alx-alexpark/macropad/macropad.kicad_pcb

## KiCad design macropad.kicad_pcb (2025-03-19)

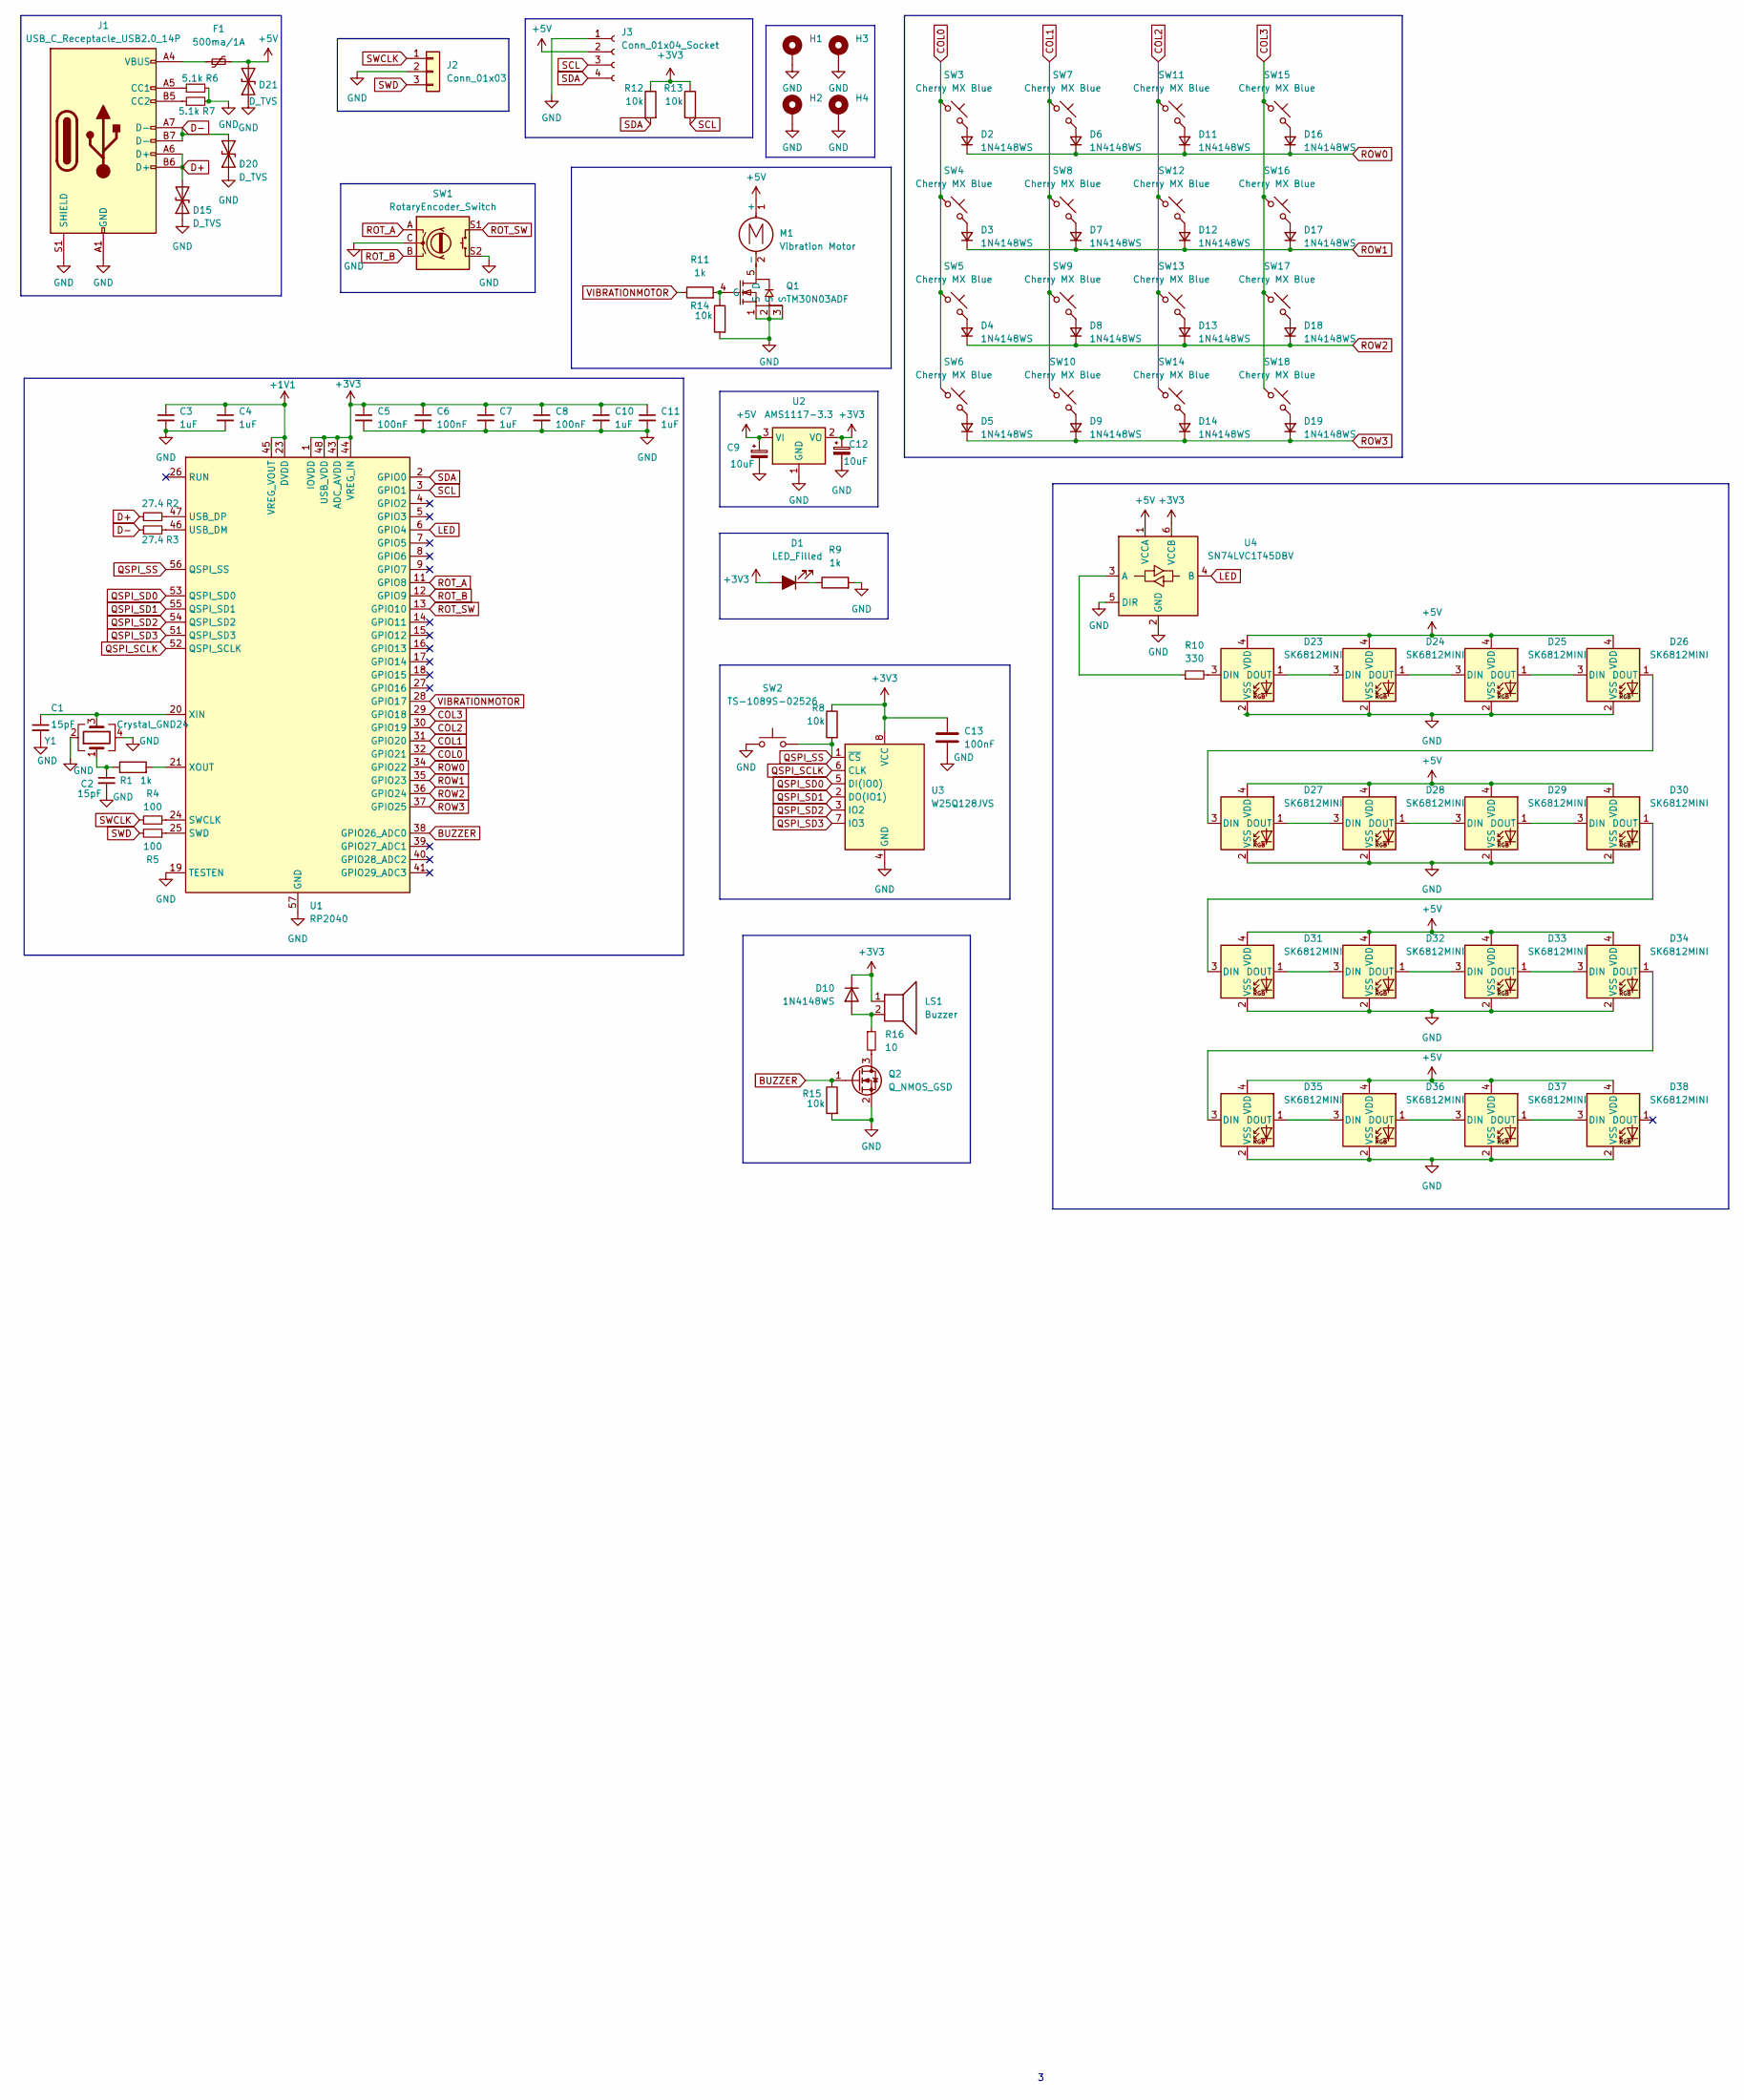
[picture p1: schematic macropad.kicad_sch]

Parts:
C1, C2: 15pF; C_0402_1005Metric; LCSC Part C1548
C3, C4, C7, C10, C11: 1uF; C_0402_1005Metric; LCSC Part C52923
C5, C6, C8, C13: 100nF; C_0402_1005Metric; LCSC Part C1525
C9, C12: 10uF; C_1206_3216Metric; LCSC Part C7171
D1: LED_Filled; LED_0603_1608Metric; LCSC Part C2286
D2, D3, D4, D5, D6, D7, D8, D9, D11, D12, D13, D14, D16, D17, D18, D19: 1N4148WS; D_SOD-323F; LCSC Part C917117
D10: 1N4148WS; D_SOD-323; LCSC Part C2828422
D15, D20, D21: D_TVS; D_SOD-923; LCSC Part C96512
D23, D24, D25, D26, D27, D28, D29, D30, D31, D32, D33, D34, D35, D36, D37, D38: SK6812MINI; SK6812MINI-E; LCSC Part C5149201
F1: 500ma/1A; Fuse_1206_3216Metric_Pad1.42x1.75mm_HandSolder; LCSC Part C720075
H1, H2, H3, H4: MountingHole_Pad; MountingHole_2.2mm_M2_DIN965_Pad
J1: USB_C_Receptacle_USB2.0_14P; USB_C_Receptacle_G-Switch_GT-USB-7010ASV; LCSC Part C2988369
J2: Conn_01x03; JST_SH_BM03B-SRSS-TB_1x03-1MP_P1.00mm_Vertical; LCSC Part C160389
J3: Conn_01x04_Socket; OLED-TH_L38.0-W12.0_HS91L02W2C01; LCSC Part C5248081
LS1: Buzzer; BUZ-SMD_4P-L8.5-W8.5-P8.50-BR; LCSC Part C94599
M1: Vibration Motor; PinHeader_1x02_P2.54mm_Vertical
Q1: TM30N03ADF; WDFN-5_L3.3-W3.3-P0.65-BL; LCSC Part C7422839
Q2: Q_NMOS_GSD; SOT-23_Handsoldering; LCSC Part C347475
R1, R9, R11: 1k; R_0402_1005Metric; LCSC Part C11702
R2, R3: 27.4; R_0603_1608Metric; LCSC Part C5126244
R4, R5: 100; R_0603_1608Metric_Pad0.98x0.95mm_HandSolder; LCSC Part C7250
R6, R7: 5.1k; R_0603_1608Metric_Pad0.98x0.95mm_HandSolder; LCSC Part C23186
R8, R12, R13, R14, R15: 10k; R_0805_2012Metric; LCSC Part C17414
R10: 330; R_0603_1608Metric_Pad0.98x0.95mm_HandSolder; LCSC Part C23138
R16: 10; R_0603_1608Metric_Pad0.98x0.95mm_HandSolder; LCSC Part C22859
SW1: RotaryEncoder_Switch; SW-TH_EC11XXXXXXXX; LCSC Part C470742
SW2: TS-1089S-02526; SW-SMD_4P-L4.2-W3.3-P2.15-LS5.1; LCSC Part C455282
SW3, SW4, SW5, SW6, SW7, SW8, SW9, SW10, SW11, SW12, SW13, SW14, SW15, SW16, SW17, SW18: Cherry MX Blue; SW_Cherry_MX_PCB_1.00u
U1: RP2040; QFN-56-1EP_7x7mm_P0.4mm_EP3.2x3.2mm; LCSC Part C2040
U2: AMS1117-3.3; SOT-223-3_TabPin2; LCSC Part C6186
U3: W25Q128JVS; SOIC-8_5.23x5.23mm_P1.27mm; LCSC Part C97521
U4: SN74LVC1T45DBV; SOT-23-6; LCSC Part C7843
Y1: Crystal_GND24; Crystal_SMD_3225-4Pin_3.2x2.5mm; LCSC Part C20625731

Connections:
+1V1: C3.1, C4.1, U1.23 (DVDD), U1.45 (VREG_VOUT), U1.50 (DVDD)
+3V3: C5.1, C6.1, C7.1, C8.1, C10.1, C11.1, C12.1, C13.1, D1.2 (A), D10.1 (K), LS1.1, R8.1, R12.1, R13.1, U1.1 (IOVDD), U1.10 (IOVDD), U1.22 (IOVDD), U1.33 (IOVDD), U1.42 (IOVDD), U1.43 (ADC_AVDD), U1.44 (VREG_IN), U1.48 (USB_VDD), U1.49 (IOVDD), U2.2 (VO), U3.8 (VCC), U4.6 (VCCB)
+5V: C9.1, D21.2 (A2), D23.4 (VDD), D24.4 (VDD), D25.4 (VDD), D26.4 (VDD), D27.4 (VDD), D28.4 (VDD), D29.4 (VDD), D30.4 (VDD), D31.4 (VDD), D32.4 (VDD), D33.4 (VDD), D34.4 (VDD), D35.4 (VDD), D36.4 (VDD), D37.4 (VDD), D38.4 (VDD), F1.2, J3.2, M1.1 (+), U2.3 (VI), U4.1 (VCCA)
BUZZER: Q2.1 (G), R15.1, U1.38 (GPIO26_ADC0)
COL0: SW3.1, SW4.1, SW5.1, SW6.1, U1.32 (GPIO21)
COL1: SW7.1, SW8.1, SW9.1, SW10.1, U1.31 (GPIO20)
COL2: SW11.1, SW12.1, SW13.1, SW14.1, U1.30 (GPIO19)
COL3: SW15.1, SW16.1, SW17.1, SW18.1, U1.29 (GPIO18)
D+: D15.2 (A2), J1.A6 (D+), J1.B6 (D+), R2.1
D-: D20.2 (A2), J1.A7 (D-), J1.B7 (D-), R3.1
GND: C1.2, C2.2, C3.2, C4.2, C5.2, C6.2, C7.2, C8.2, C9.2, C10.2, C11.2, C12.2, C13.2, D15.1 (A1), D20.1 (A1), D21.1 (A1), D23.2 (VSS), D24.2 (VSS), D25.2 (VSS), D26.2 (VSS), D27.2 (VSS), D28.2 (VSS), D29.2 (VSS), D30.2 (VSS), D31.2 (VSS), D32.2 (VSS), D33.2 (VSS), D34.2 (VSS), D35.2 (VSS), D36.2 (VSS), D37.2 (VSS), D38.2 (VSS), H1.1, H2.1, H3.1, H4.1, J1.A1 (GND), J1.A12 (GND), J1.B1 (GND), J1.B12 (GND), J1.S1 (SHIELD), J2.2, J3.1, Q1.1 (S), Q1.2 (S), Q1.3 (S), Q2.2 (S), R6.2, R7.2, R9.2, R14.2, R15.2, SW1.C, SW1.S2, SW2.1, U1.19 (TESTEN), U1.57 (GND), U2.1 (GND), U3.4 (GND), U4.2 (GND), U4.5 (DIR), Y1.2, Y1.4
LED: U1.6 (GPIO4), U4.4 (B)
unnamed: C2.1, R1.1, Y1.1
unnamed: D1.1 (K), R9.1
unnamed: D2.2 (A), SW3.2
unnamed: D3.2 (A), SW4.2
unnamed: D4.2 (A), SW5.2
unnamed: D5.2 (A), SW6.2
unnamed: D6.2 (A), SW7.2
unnamed: D7.2 (A), SW8.2
unnamed: D8.2 (A), SW9.2
unnamed: D9.2 (A), SW10.2
unnamed: D10.2 (A), LS1.2, R16.1
unnamed: D11.2 (A), SW11.2
unnamed: D12.2 (A), SW12.2
unnamed: D13.2 (A), SW13.2
unnamed: D14.2 (A), SW14.2
unnamed: D16.2 (A), SW15.2
unnamed: D17.2 (A), SW16.2
unnamed: D18.2 (A), SW17.2
unnamed: D19.2 (A), SW18.2
unnamed: D23.3 (DIN), R10.2
unnamed: D23.1 (DOUT), D24.3 (DIN)
unnamed: D24.1 (DOUT), D25.3 (DIN)
unnamed: D25.1 (DOUT), D26.3 (DIN)
unnamed: D26.1 (DOUT), D27.3 (DIN)
unnamed: D27.1 (DOUT), D28.3 (DIN)
unnamed: D28.1 (DOUT), D29.3 (DIN)
unnamed: D29.1 (DOUT), D30.3 (DIN)
unnamed: D30.1 (DOUT), D31.3 (DIN)
unnamed: D31.1 (DOUT), D32.3 (DIN)
unnamed: D32.1 (DOUT), D33.3 (DIN)
unnamed: D33.1 (DOUT), D34.3 (DIN)
unnamed: D34.1 (DOUT), D35.3 (DIN)
unnamed: D35.1 (DOUT), D36.3 (DIN)
unnamed: D36.1 (DOUT), D37.3 (DIN)
unnamed: D37.1 (DOUT), D38.3 (DIN)
unnamed: F1.1, J1.A4 (VBUS), J1.A9 (VBUS), J1.B4 (VBUS), J1.B9 (VBUS)
unnamed: J1.A5 (CC1), R6.1
unnamed: J1.B5 (CC2), R7.1
unnamed: M1.2 (-), Q1.5 (D)
unnamed: Q1.4 (G), R11.2, R14.1
unnamed: Q2.3 (D), R16.2
unnamed: R4.2, U1.24 (SWCLK)
unnamed: R5.1, U1.25 (SWD)
unnamed: R3.2, U1.46 (USB_DM)
unnamed: R2.2, U1.47 (USB_DP)
unnamed: C1.1, U1.20 (XIN), Y1.3
unnamed: R1.2, U1.21 (XOUT)
unnamed: R10.1, U4.3 (A)
QSPI_SCLK: U1.52 (QSPI_SCLK), U3.6 (CLK)
QSPI_SD0: U1.53 (QSPI_SD0), U3.5 (DI(IO0))
QSPI_SD1: U1.55 (QSPI_SD1), U3.2 (DO(IO1))
QSPI_SD2: U1.54 (QSPI_SD2), U3.3 (IO2)
QSPI_SD3: U1.51 (QSPI_SD3), U3.7 (IO3)
QSPI_SS: R8.2, SW2.2, U1.56 (QSPI_SS), U3.1 (~CS)
ROT_A: SW1.A, U1.11 (GPIO8)
ROT_B: SW1.B, U1.12 (GPIO9)
ROT_SW: SW1.S1, U1.13 (GPIO10)
ROW0: D2.1 (K), D6.1 (K), D11.1 (K), D16.1 (K), U1.34 (GPIO22)
ROW1: D3.1 (K), D7.1 (K), D12.1 (K), D17.1 (K), U1.35 (GPIO23)
ROW2: D4.1 (K), D8.1 (K), D13.1 (K), D18.1 (K), U1.36 (GPIO24)
ROW3: D5.1 (K), D9.1 (K), D14.1 (K), D19.1 (K), U1.37 (GPIO25)
SCL: J3.3, R13.2, U1.3 (GPIO1)
SDA: J3.4, R12.2, U1.2 (GPIO0)
SWCLK: J2.1, R4.1
SWD: J2.3, R5.2
VIBRATIONMOTOR: R11.1, U1.28 (GPIO17)

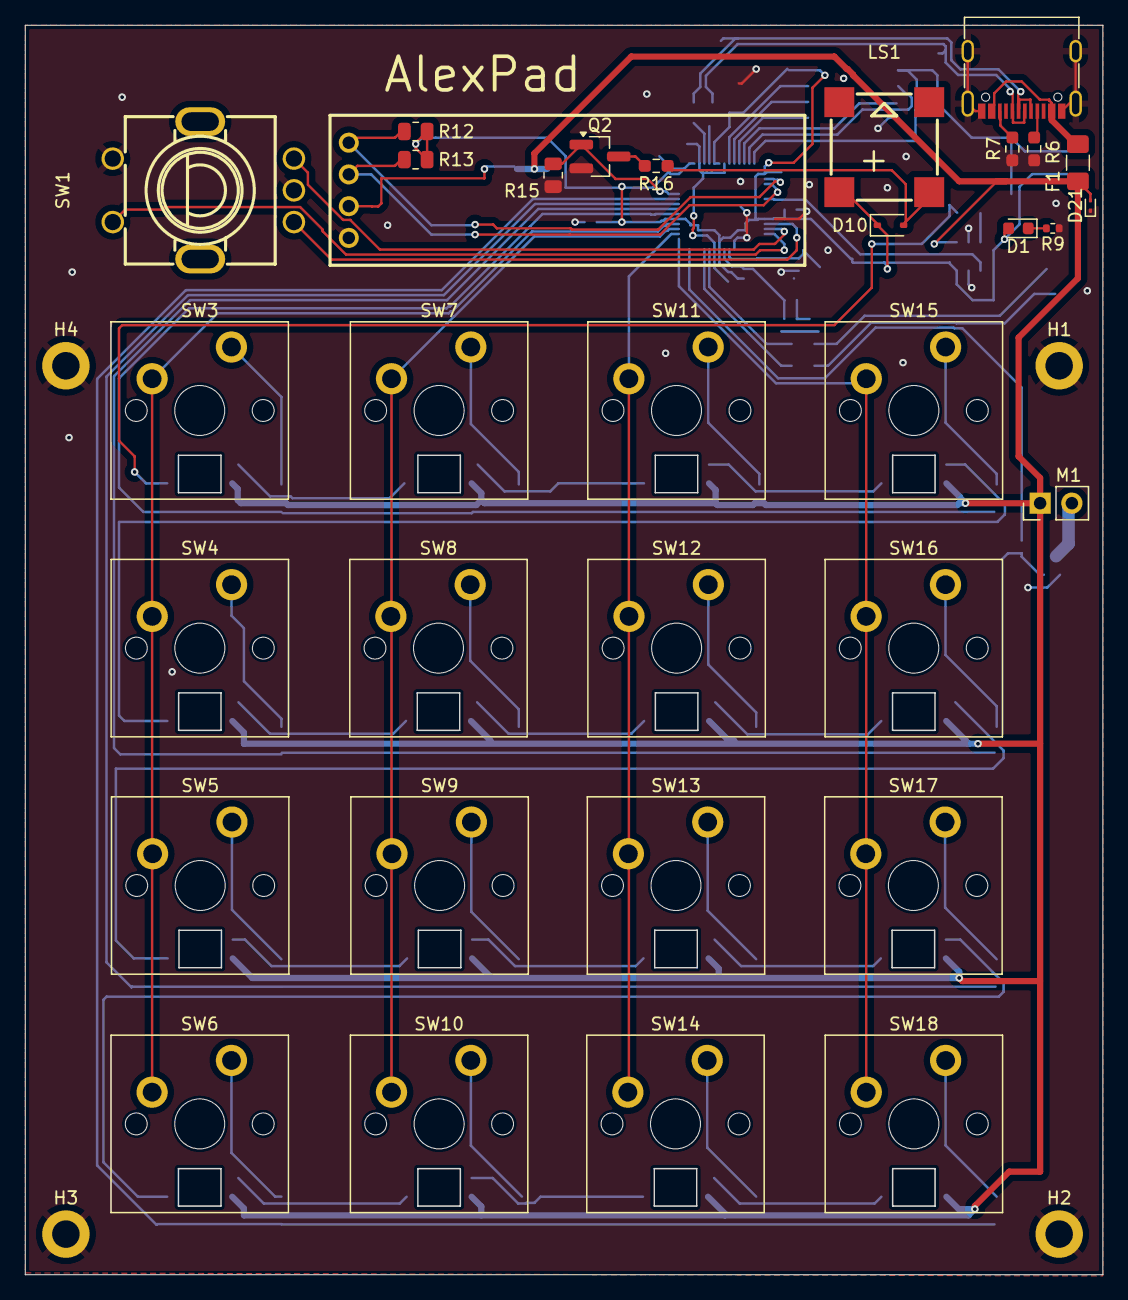
[picture p2: board macropad.kicad_pcb from above]

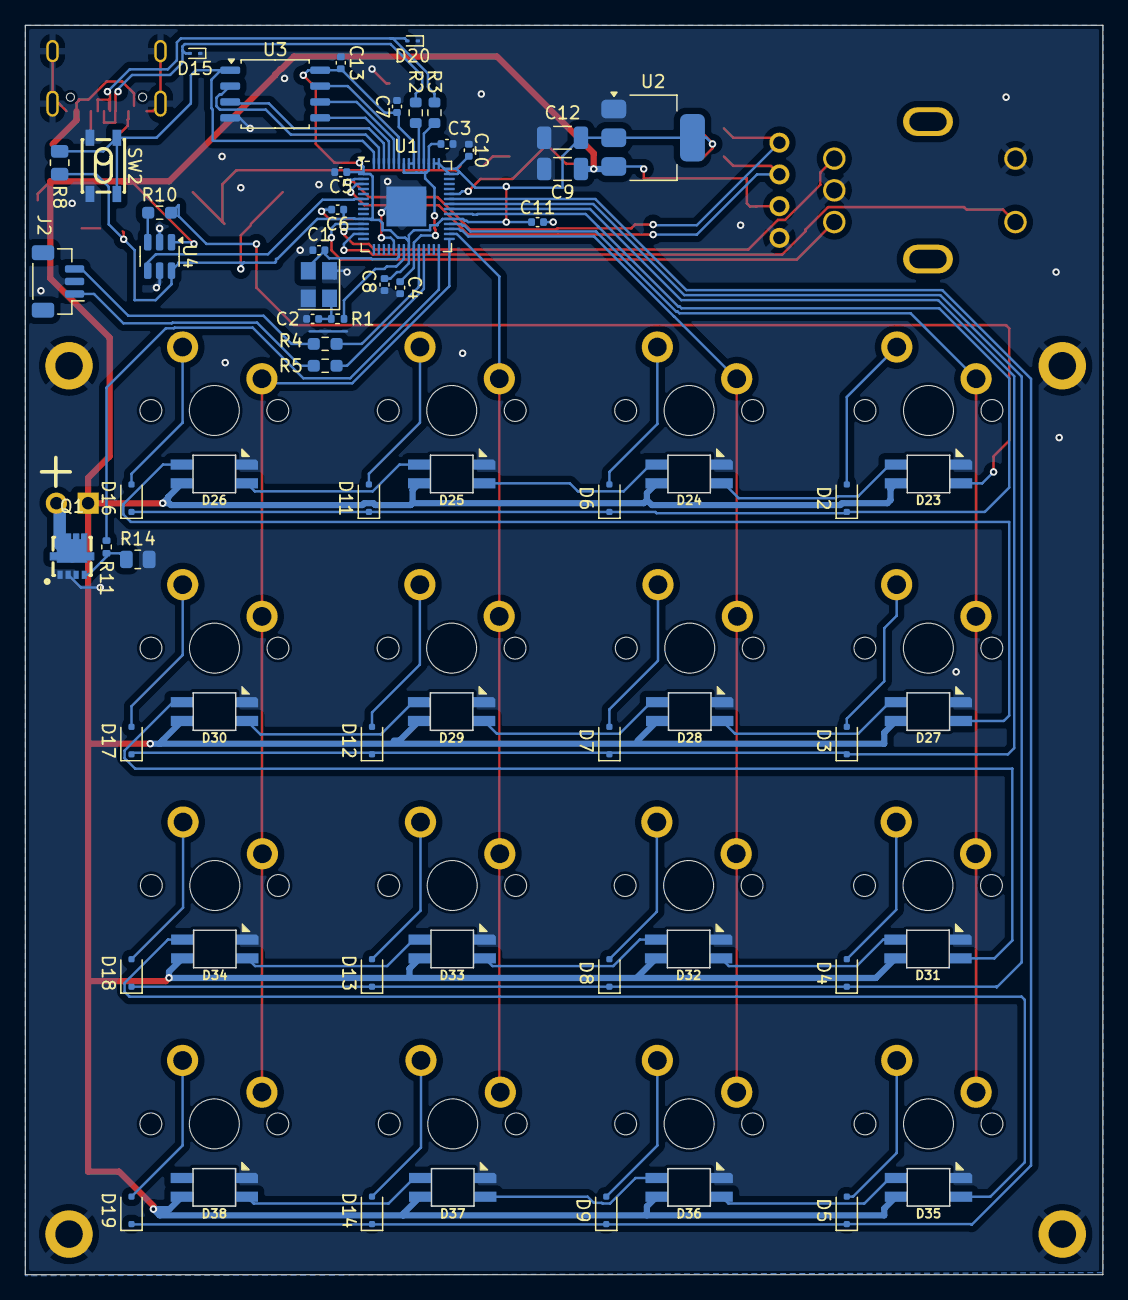
[picture p3: board macropad.kicad_pcb from below]

Board: 2 copper layers, 86.2 x 100.0 mm, 101 parts (64 on the bottom side), 78 nets.
