alx-alexpark/macropad/(commit log)

2025-01-28 Change MCU
    [macropad.kicad_pcb, macropad.kicad_sch]
2025-01-31 did some layout things
    [macropad.kicad_pcb, macropad.kicad_sch]
2025-02-02 Commit before upgrading to 9rc-2
    [macropad.kicad_pcb, macropad.kicad_sch]
2025-02-10 I did things
    [macropad.kicad_pcb, macropad.kicad_sch]
2025-02-16 save things before kicad breaks stuff
    [macropad.kicad_pcb, macropad.kicad_sch]
2025-02-16 almost done
    [macropad.kicad_pcb, macropad.kicad_sch]
2025-03-19 Final product: version 1
    [macropad.kicad_pcb, macropad.kicad_sch]
